thinkl33t/HACCESS/README

Hackspace Access Control/Card Entry Sentry System
=================================================

Access Control nodes for the hackspace
