thinkl33t/HACCESS/Laser Cut/haccess.png

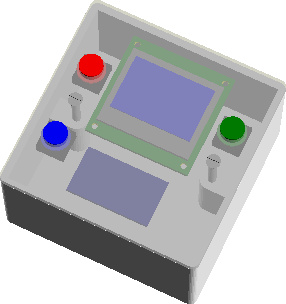
Laser Cut/haccess.png
