thinkl33t/HACCESS/Laser Cut/PattressPlate2.dxf

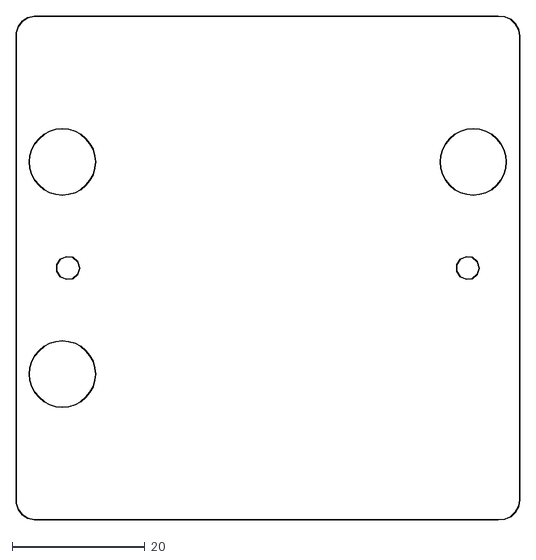
[picture p2: CAD file, 2015-10-27]
Laser Cut/PattressPlate2.dxf
76.0 x 76.0
