thinkl33t/HACCESS/Laser Cut/PattressPlate.dxf

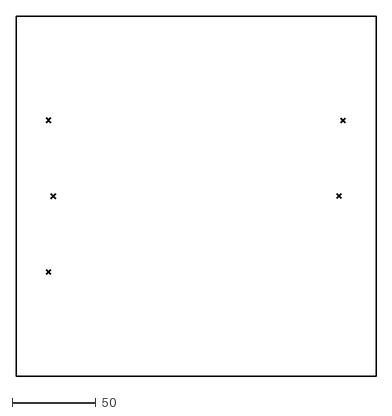
[picture p3: CAD file, 2015-10-27]
Laser Cut/PattressPlate.dxf
215.4 x 215.4
