thinkl33t/HACCESS/prototype1/pcb/release-v1r1/haccess-v1.pdf

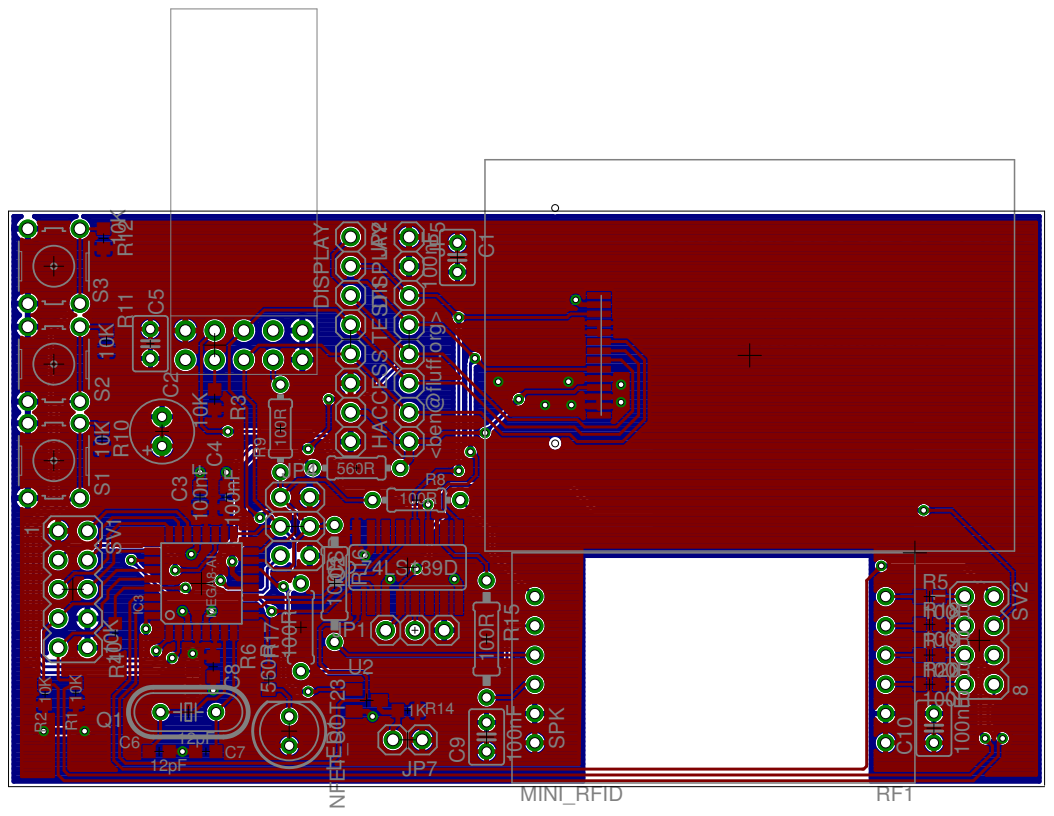
[picture p4: page 1]

12pF
C6 | C7
