thinkl33t/HACCESS/schematics/haccess.brd

## EAGLE design schematics/haccess.brd (2015-12-23)

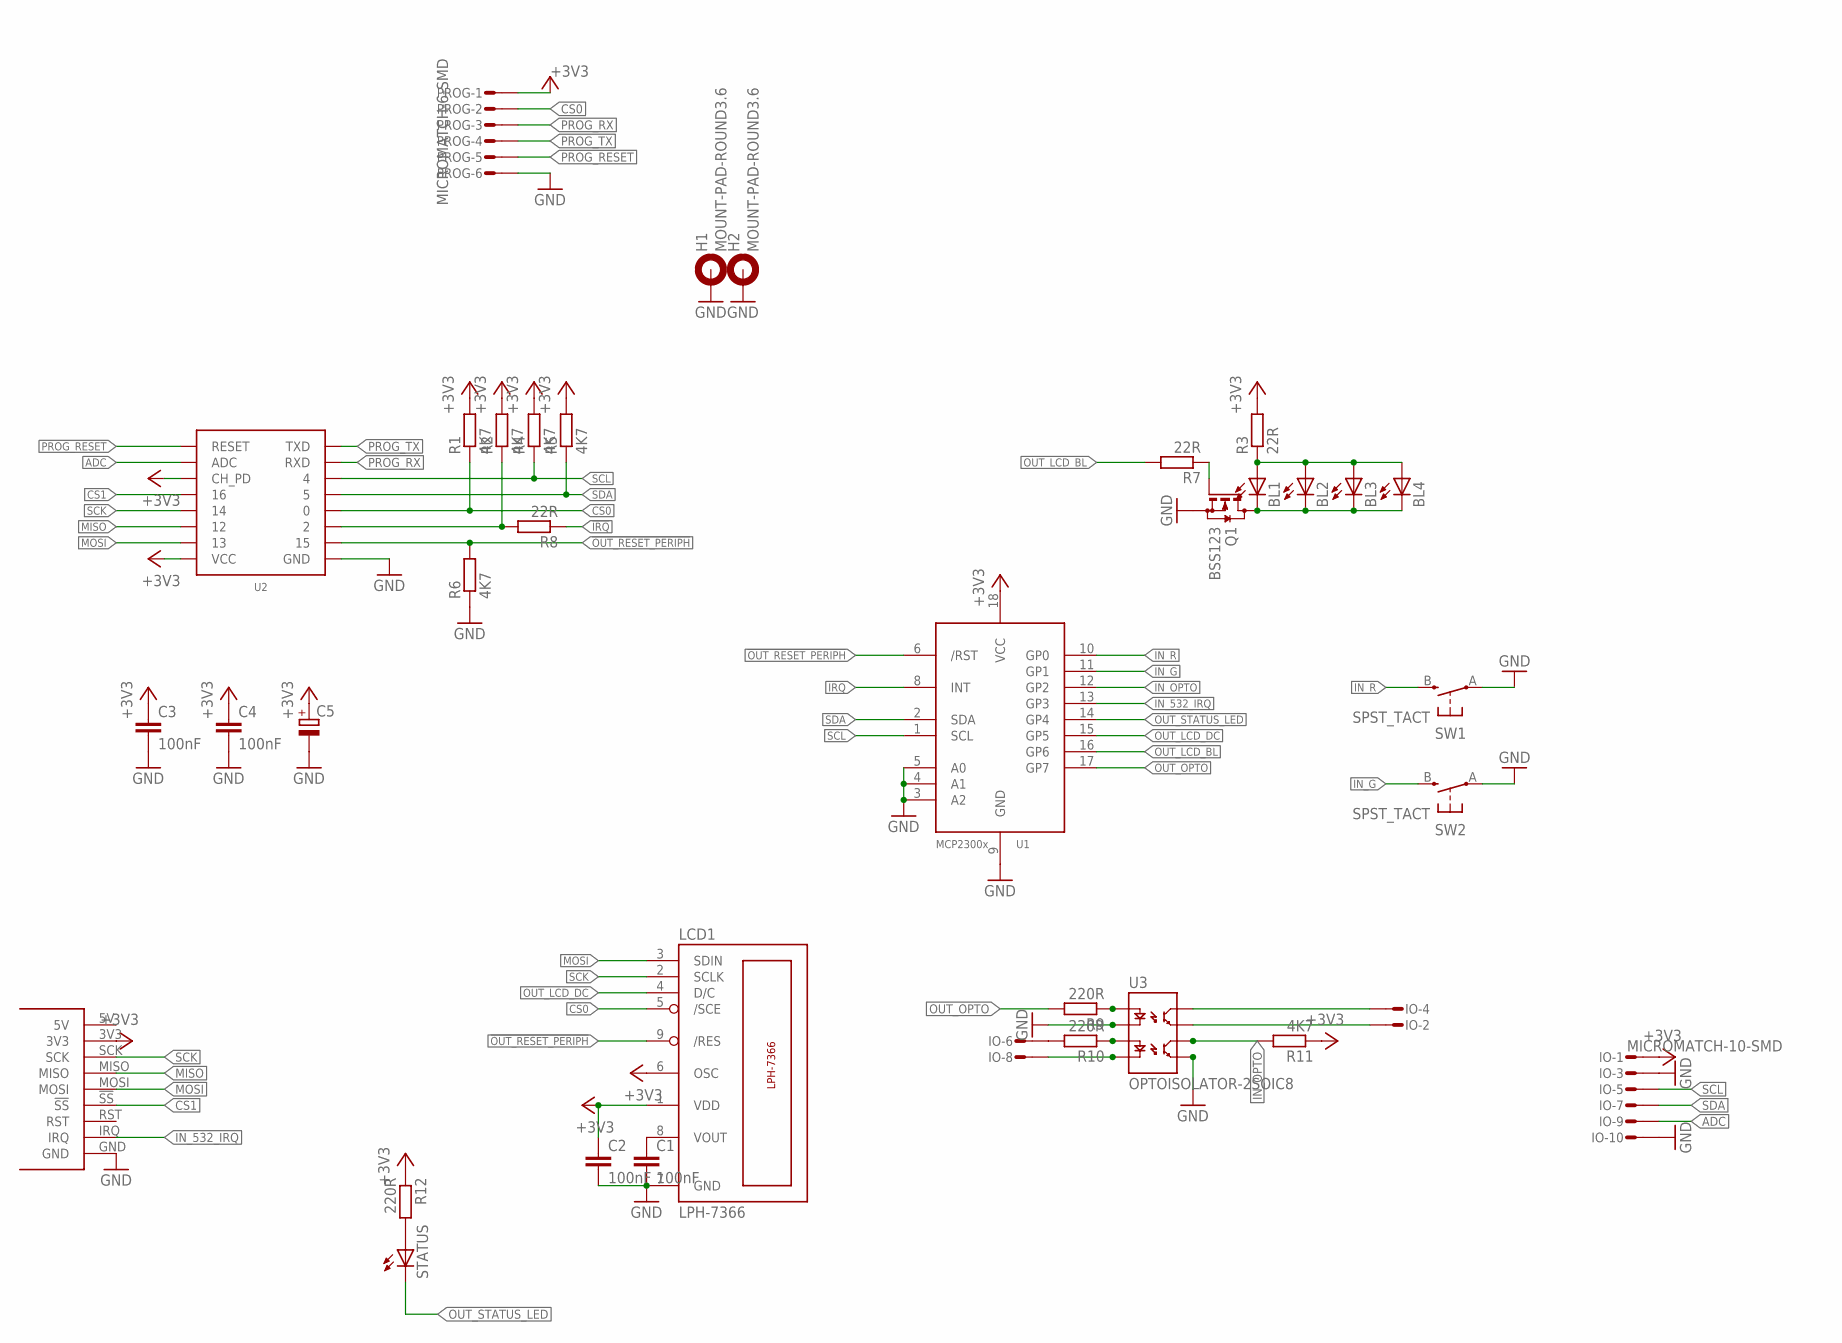
[picture p5: schematic haccess.sch]

Parts:
BL1, BL2, BL3, BL4: LEDCHIPLED_0805; CHIPLED_0805
C1, C2, C3, C4: 100nF; C0805K
C5: CPOL-EUSMCB; SMC_B
H1, H2: MOUNT-PAD-ROUND3.6; 3,6-PAD
IO: MICROMATCH-10-SMD
LCD1: LPH-7366
PROG: MICROMATCH-6-SMD
Q1: BSS123; SOT23
R1, R2, R4, R5, R6, R11: 4K7; R0603
R3, R7, R8: 22R; R0603
R9, R10, R12: 220R; R0603
STATUS: LEDCHIP-LED0805; CHIP-LED0805
SW1, SW2: SPST_TACT; SKPMAPE010
U1: MCP2300X/SO; SO18W
U2: ESP826607B; ESP-07B
U3: OPTOISOLATOR-2SOIC8; SO08-2
U$1: PN532SMALLMODULE; SMALL-MODULE

Connections:
!IRQ: R8.1, U1.8 (INT)
!IRQ_1: R2.1, R8.2, U2.GPIO2 (2)
!OUT_RESET_PERIPH: LCD1.9 (/RES), R6.2, U1.6 (/RST), U2.GPIO15 (15)
+3V3: C2.1, C3.1, C4.1, C5.+, IO.1, LCD1.1 (VDD), LCD1.6 (OSC), PROG.1, R1.2, R2.2, R3.2, R4.2, R5.2, R11.1, R12.1, U1.18 (VCC), U2.CH_PD, U2.VCC, U$1.3V3
ADC: IO.9, U2.ADC
CS0: LCD1.5 (/SCE), PROG.2, R1.1, U2.GPIO0 (0)
CS1: U2.GPIO16 (16), U$1.!SS
GND: C1.2, C2.2, C3.2, C4.2, C5.-, H1.B3,6, H2.B3,6, IO.3, IO.10, LCD1.7 (GND), PROG.6, Q1.2 (S), R6.1, SW1.A, SW2.A, U1.3 (A2), U1.4 (A1), U1.5 (A0), U1.9 (GND), U2.GND, U3.2 (C1), U3.5 (EM2), U$1.GND
IN_532_IRQ: U1.13 (GP3), U$1.IRQ
IN_G: SW2.B (S), U1.11 (GP1)
IN_OPTO: R11.2, U1.12 (GP2), U3.6 (CL2)
IN_OPTO_A: IO.6, R10.2
IN_OPTO_C: IO.8, U3.4 (C2)
IN_R: SW1.B (S), U1.10 (GP0)
MISO: U2.GPIO12 (12), U$1.MISO
MOSI: LCD1.3 (SDIN), U2.GPIO13 (13), U$1.MOSI
unnamed: C1.1, LCD1.8 (VOUT)
unnamed: R12.2, STATUS.A
unnamed: R9.1, U3.1 (A1)
unnamed: R10.1, U3.3 (A2)
unnamed: IO.4, U3.8 (CL1)
unnamed: IO.2, U3.7 (EM1)
unnamed: BL1.C, BL2.C, BL3.C, BL4.C, Q1.3 (D)
unnamed: BL1.A, BL2.A, BL3.A, BL4.A, R3.1
unnamed: Q1.1 (G), R7.1
OUT_LCD_BL: R7.2, U1.16 (GP6)
OUT_LCD_DC: LCD1.4 (D/C), U1.15 (GP5)
OUT_OPTO: R9.2, U1.17 (GP7)
OUT_STATUS_LED: STATUS.C, U1.14 (GP4)
PROG_RESET: PROG.5, U2.RESET
PROG_RX: PROG.3, U2.RXD
PROG_TX: PROG.4, U2.TXD
SCK: LCD1.2 (SCLK), U2.GPIO14 (14), U$1.SCK
SCL: IO.5, R4.1, U1.1 (SCL), U2.GPIO4 (4)
SDA: IO.7, R5.1, U1.2 (SDA), U2.GPIO5 (5)

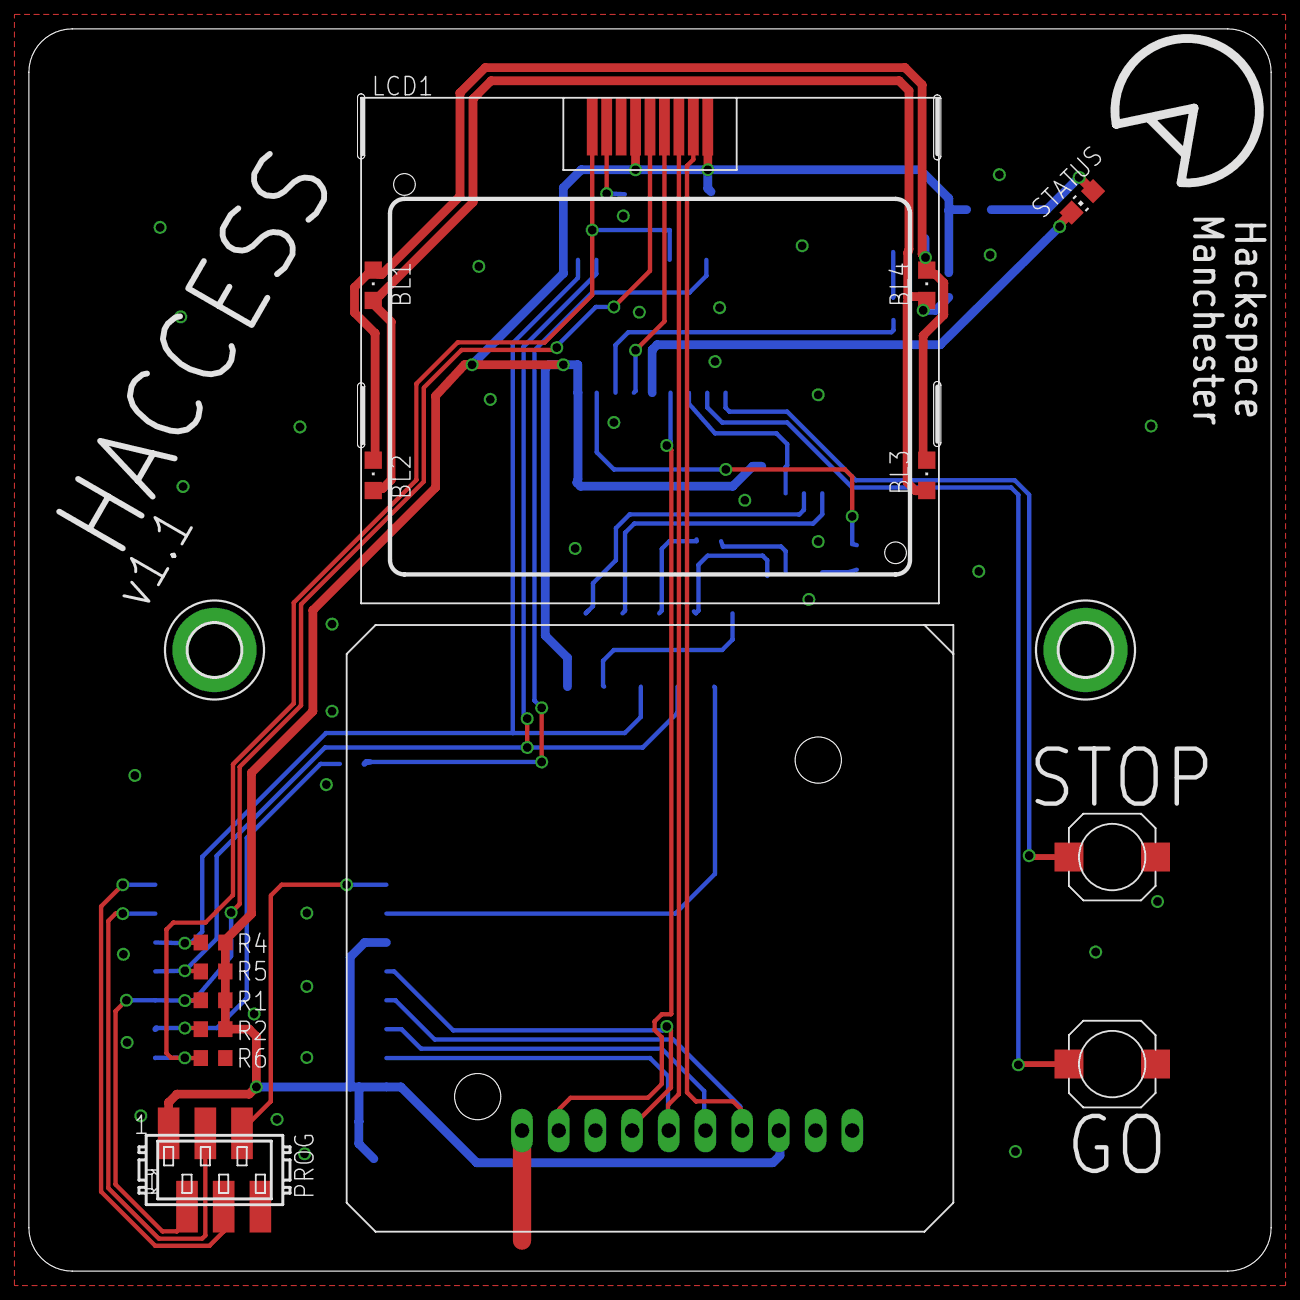
[picture p6: board haccess.brd from above]

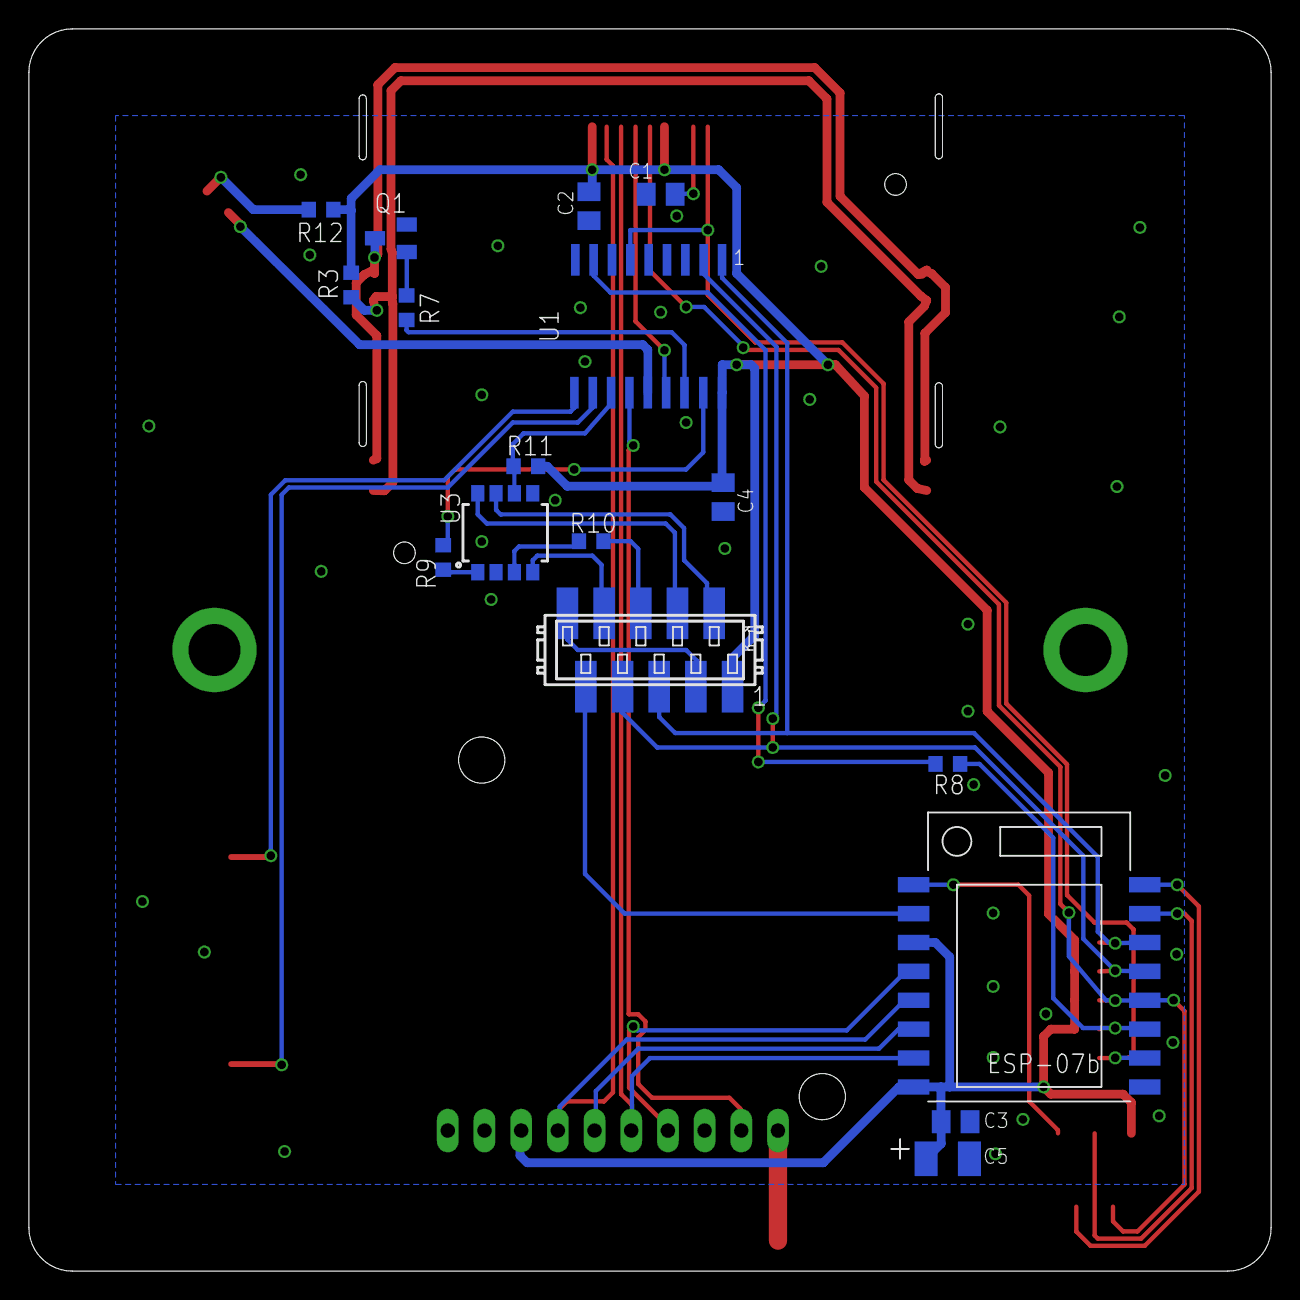
[picture p7: board haccess.brd from below]

Board: 2 copper layers, 86.0 x 86.0 mm, 34 parts (17 on the bottom side), 35 nets.
