thinkl33t/HACCESS/prototype1/pcb/release-v1r1/haccess-v1.brd

## EAGLE design prototype1/pcb/release-v1r1/haccess-v1.brd (2014-10-31)

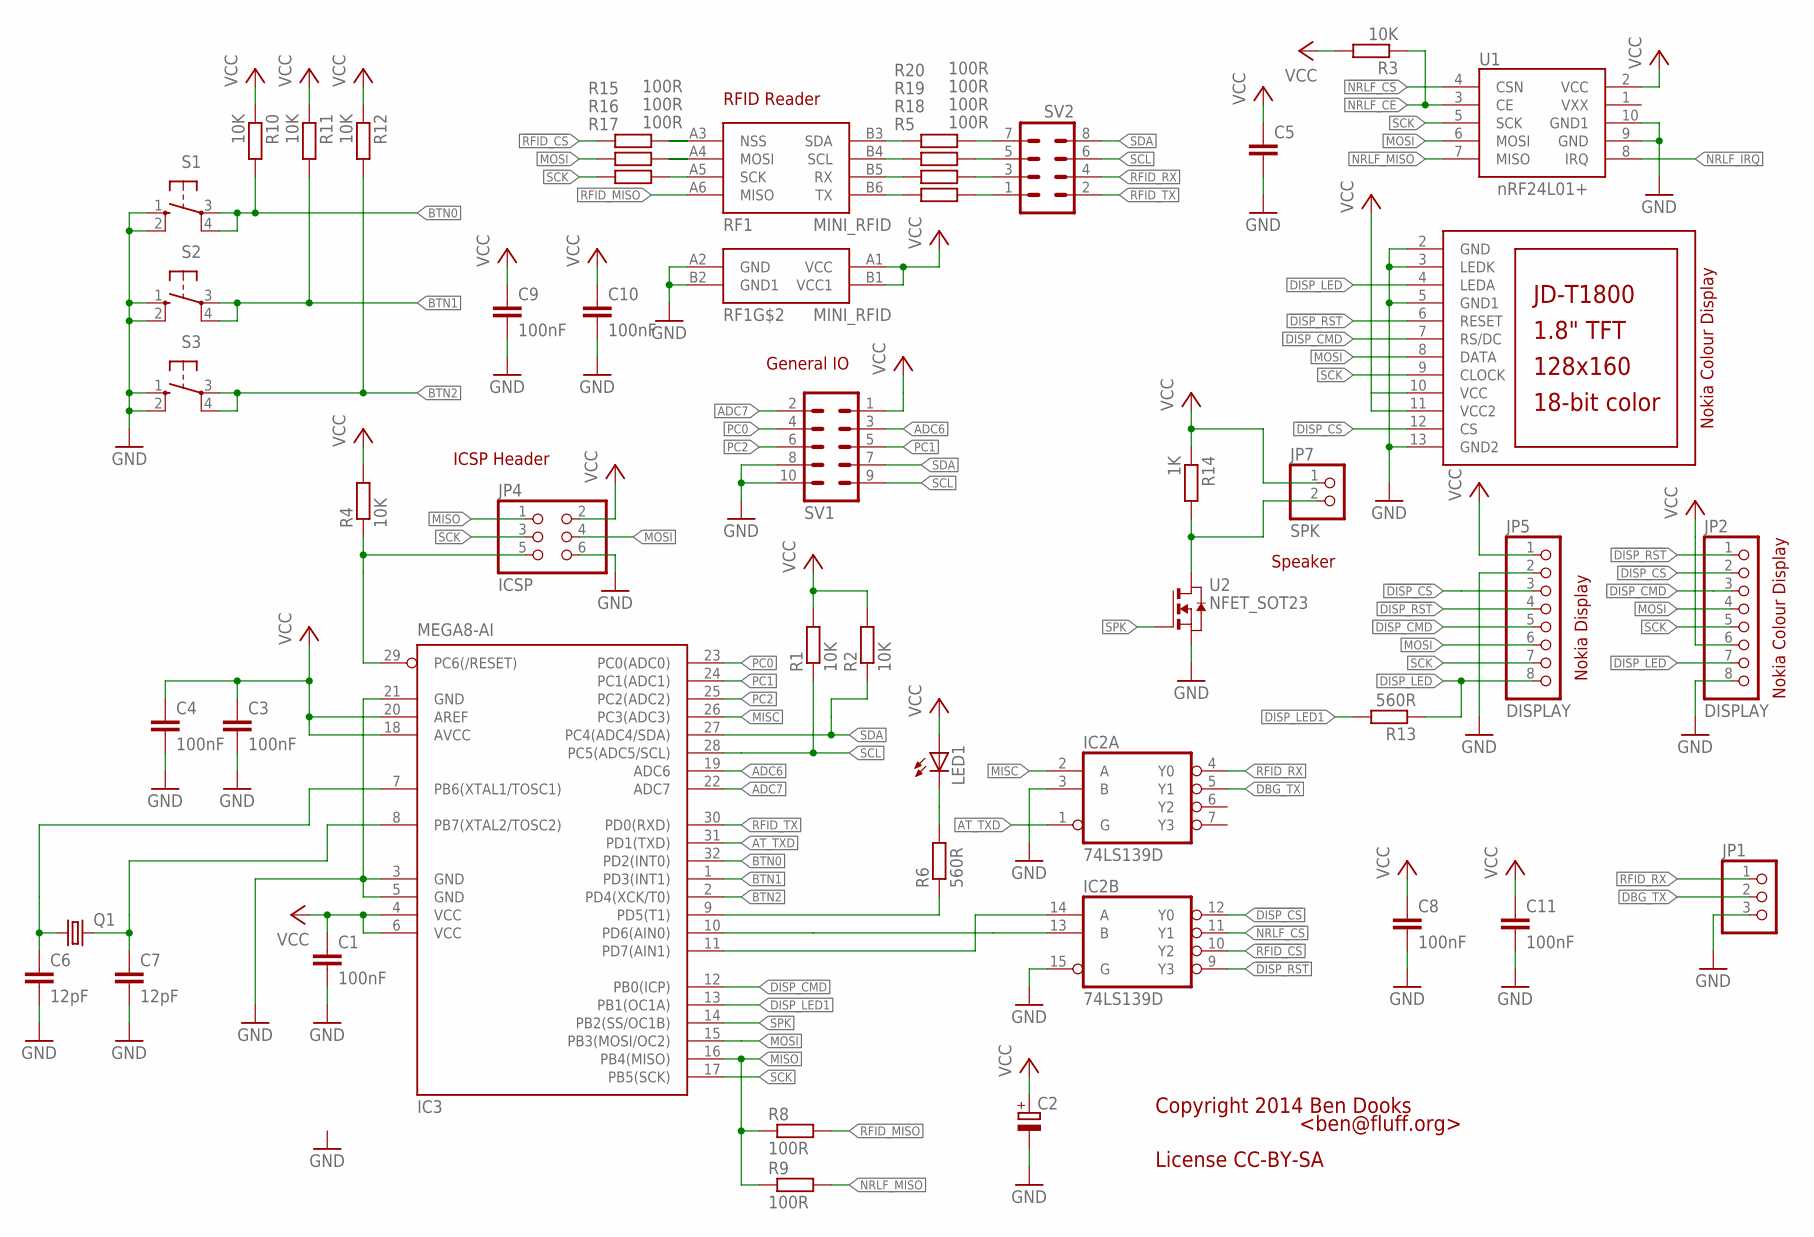
[picture p8: schematic haccess-v1.sch]

Parts:
C1, C9, C10: 100nF; C025-030X050
C2: CPOL-EUE2.5-6; E2,5-6
C3, C4, C8, C11: 100nF; C0603K
C5: C-EU025-030X050; C025-030X050
C6, C7: 12pF; C0603K
IC2: 74LS139D; SO16
IC3: MEGA8-AI; TQFP32-08
JP1: PINHD-1X3; 1X03
JP2, JP5: DISPLAY; 1X08
JP4: ICSP; 2X03
JP7: SPK; 1X02
LCD1: JD-T1800
LED1: LED5MM
Q1: CRYSTALHC49S; HC49/S
R1, R2, R3, R4, R10, R11, R12: 10K; R0603
R5, R18, R19, R20: 100R; R0603
R6: 560R; R0603
R8, R9: 100R; 0204/7
R13: 560R; 0204/7
R14: 1K; R0603
R15, R16: 100R; 0207/10
R17: 100R; 0207/7
RF1: MINI_RFID
S1, S2, S3: 10-XX; B3F-10XX
SV1: MA05-2
SV2: MA04-2
U1: NRF24L01+CHINESE-10PIN; CHINESE-10PIN
U2: NFET_SOT23; SOT23

Connections:
!DISP_CS: IC2.12 (Y0), JP2.2, JP5.3, LCD1.12 (CS)
!DISP_RST: IC2.9 (Y3), JP2.1, JP5.4, LCD1.6 (RESET)
!NRLF_CS: IC2.11 (Y1), U1.4 (CSN)
!RESET: IC3.29 (PC6(/RESET)), JP4.5, R4.1
!RFID_CS: IC2.10 (Y2), R15.1
ADC6: IC3.19 (ADC6), SV1.3
ADC7: IC3.22 (ADC7), SV1.2
AT_TXD: IC2.1 (G), IC3.31 (PD1(TXD))
BTN0: IC3.32 (PD2(INT0)), R10.2, S1.3, S1.4 (P1)
BTN1: IC3.1 (PD3(INT1)), R11.2, S2.3, S2.4 (P1)
BTN2: IC3.2 (PD4(XCK/T0)), R12.2, S3.3, S3.4 (P1)
DBG_TX: IC2.5 (Y1), JP1.2
DISP_CMD: IC3.12 (PB0(ICP)), JP2.3, JP5.5, LCD1.7 (RS/DC)
DISP_LED: JP2.7, JP5.8, LCD1.4 (LEDA), R13.1
DISP_LED1: IC3.13 (PB1(OC1A)), R13.2
GND: C1.2, C2.-, C3.2, C4.2, C5.2, C6.2, C7.2, C8.2, C9.2, C10.2, C11.2, IC2.3 (B), IC2.8 (GND), IC2.15 (G), IC3.3 (GND), IC3.5 (GND), IC3.21 (GND), JP1.3, JP2.8, JP4.6, JP5.2, LCD1.2 (GND), LCD1.3 (LEDK), LCD1.5 (GND1), LCD1.13 (GND2), RF1.A2 (GND), RF1.B2 (GND1), S1.1 (S), S1.2 (S1), S2.1 (S), S2.2 (S1), S3.1 (S), S3.2 (S1), SV1.8, SV1.10, U1.9 (GND), U1.10 (GND1), U2.2 (S)
LED: IC3.9 (PD5(T1)), R6.1
LED1: LED1.K (C), R6.2
MISC: IC2.2 (A), IC3.26 (PC3(ADC3))
MISO: IC3.16 (PB4(MISO)), JP4.1, R8.1, R9.1
MOSI: IC3.15 (PB3(MOSI/OC2)), JP2.4, JP4.4, JP5.6, LCD1.8 (DATA), R16.1, U1.6 (MOSI)
unnamed: R17.2, RF1.A5 (SCK)
unnamed: R16.2, RF1.A4 (MOSI)
unnamed: R15.2, RF1.A3 (NSS)
unnamed: R5.1, RF1.B6 (TX)
unnamed: R18.1, RF1.B5 (RX)
unnamed: R19.1, RF1.B4 (SCL)
unnamed: R20.1, RF1.B3 (SDA)
unnamed: R20.2, SV2.7
unnamed: IC2.13 (B), IC3.10 (PD6(AIN0))
unnamed: R19.2, SV2.5
unnamed: IC2.14 (A), IC3.11 (PD7(AIN1))
unnamed: R18.2, SV2.3
unnamed: R5.2, SV2.1
NRLF_CE: R3.1, U1.3 (CE)
NRLF_IRQ: U1.8 (IRQ)
NRLF_MISO: R9.2, U1.7 (MISO)
PC0: IC3.23 (PC0(ADC0)), SV1.4
PC1: IC3.24 (PC1(ADC1)), SV1.5
PC2: IC3.25 (PC2(ADC2)), SV1.6
RFID_MISO: R8.2, RF1.A6 (MISO)
RFID_RX: IC2.4 (Y0), JP1.1, SV2.4
RFID_TX: IC3.30 (PD0(RXD)), SV2.2
SCK: IC3.17 (PB5(SCK)), JP2.5, JP4.3, JP5.7, LCD1.9 (CLOCK), R17.1, U1.5 (SCK)
SCL: IC3.28 (PC5(ADC5/SCL)), R1.1, SV1.9, SV2.6
SDA: IC3.27 (PC4(ADC4/SDA)), R2.1, SV1.7, SV2.8
SPK: IC3.14 (PB2(SS/OC1B)), U2.1 (G)
SPK1: JP7.2, R14.2, U2.3 (D)
VCC: C1.1, C2.+, C3.1, C4.1, C5.1, C8.1, C9.1, C10.1, C11.1, IC2.16 (VCC), IC3.4 (VCC), IC3.6 (VCC), IC3.18 (AVCC), IC3.20 (AREF), JP2.6, JP4.2, JP5.1, JP7.1, LCD1.10 (VCC), LCD1.11 (VCC2), LED1.A, R1.2, R2.2, R3.2, R4.2, R10.1, R11.1, R12.1, R14.1, RF1.A1 (VCC), RF1.B1 (VCC1), SV1.1, U1.2 (VCC)
XT1: C6.1, IC3.7 (PB6(XTAL1/TOSC1)), Q1.1
XT2: C7.1, IC3.8 (PB7(XTAL2/TOSC2)), Q1.2

Notes on the sheet:
RFID Reader
General IO
Nokia Display
ICSP Header
Speaker
Copyright 2014 Ben Dooks
<ben@fluff.org>
License CC-BY-SA
Nokia Colour Display

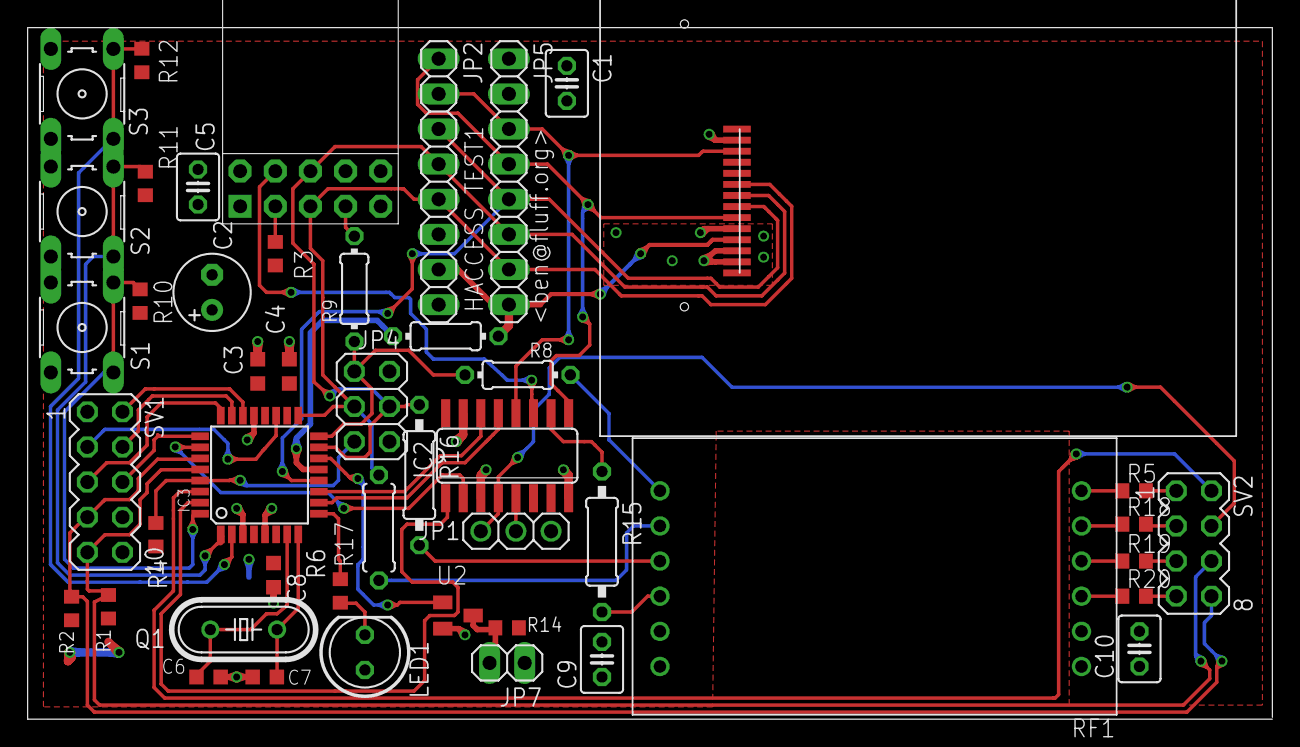
[picture p9: board haccess-v1.brd from above]

Board: 2 copper layers, 90.0 x 50.0 mm, 48 parts (1 on the bottom side), 50 nets.
