thinkl33t/HACCESS/(commit log)

2013-10-22 Initial Commit - Pattress plate v0.01
    [PattressPlate.scad]
2013-10-22 Added pattress box, split off rounded rect etc into its own library. Created LCD and RFID models.
    [HACCESS.scad, Pattress.scad, PattressPlate.scad, lib.scad]
2013-10-23 Rounded off corners, fixed rfid hole diameter
    [HACCESS.scad, lib.scad]
2014-05-21 Updated 3d model to new parts. Added Buttons
    [HACCESS.scad, PattressPlate.scad, lib.scad]
2014-05-21 added screw to haccess
    [HACCESS.scad, lib.scad]
2014-05-21 Added blue button for training
    [HACCESS.scad, PattressPlate.scad]
2014-10-31 prototype pcb1
    [haccess-v1.GBL, haccess-v1.GBO, haccess-v1.GBP, haccess-v1.GBS, haccess-v1.GTL, haccess-v1.GTO, haccess-v1.GTP, haccess-v1.GTS]
2015-05-26 HACCESS Schematic
    v1 of HACCESS board design. needs USB protection adding, along
    with possibly FM1701 chip & componants directly on the PCB.
    [haccess.sch]
2015-05-28 First version of haccess PCB
    Has components in correct places, some minimal routing.
    Modified pattress plate to add correclty spaced holes for bolting haccess to plate.
    [PattressPlate.scad, haccess.brd, haccess.sch]
2015-09-10 Imported DXF of outline, got all important tuff into place, began routing
    [haccess.brd, haccess.sch]
2015-09-10 Modified pattress plate layout to add pcb size etc, exported PCB
    [PattressPlate.dxf, PattressPlate.scad, PattressPlate2.dxf]
2015-12-09 Routed board
    [haccess.brd, haccess.sch]
2015-12-09 Ran DRC, added holes for mounting LCD
    [haccess.brd]
2015-12-10 Added extra decoupling caps to ESP and MCP, added resistor to IRQ line, increased size of +3V3 lines, improved routing, fixed ground plane under ESP, changed switches to SKPMAPE010
    [haccess.brd, haccess.sch]
2015-12-10 Added gerber files for production
    [haccess.GBL, haccess.GBO, haccess.GBP, haccess.GBS, haccess.GTL, haccess.GTO, haccess.GTP, haccess.GTS]
2015-12-11 Added tant cap, increased size of 3V lines, improved documentation silks
    [haccess.GBL, haccess.GBO, haccess.GBP, haccess.GBS, haccess.GTL, haccess.GTO, haccess.GTP, haccess.GTS]
2015-12-21 Board as purchased
    [haccess.brd]
2015-12-22 Changed backlight to use 0805 pads - still usable with 0603 parts, but easier to solder
    [haccess.brd, haccess.sch]
2015-12-22 Moved Status LED onto pin expander, i2c and LCD reset pins onto pin 15
    [haccess.brd, haccess.sch]
2015-12-23 Increased status LED track sizes, changed 0805 leds to consistent package
    [haccess.brd, haccess.sch]
2015-12-23 Increased aerial keepout, routing tweaks
    [haccess.brd]
